norahueppi/Marvin_hw/Gehaeuse/BTN_V2.2.stl

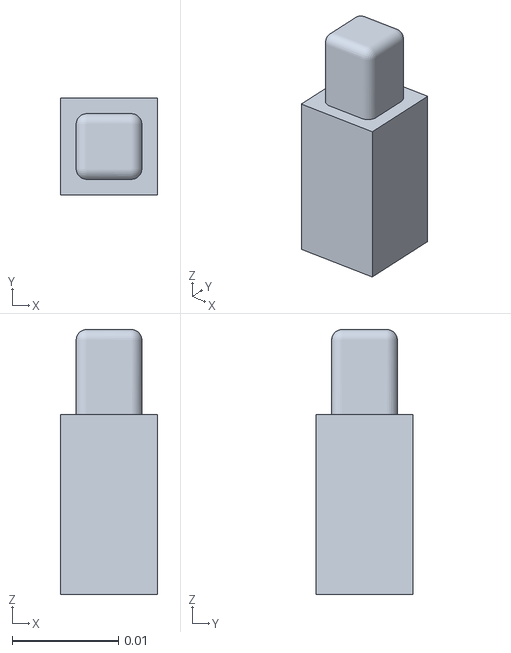
[picture p1: CAD file, 2025-06-20]
Gehaeuse/BTN_V2.2.stl
0.00913 x 0.00913 x 0.025
