norahueppi/Marvin_hw/Gehaeuse/Front.stl

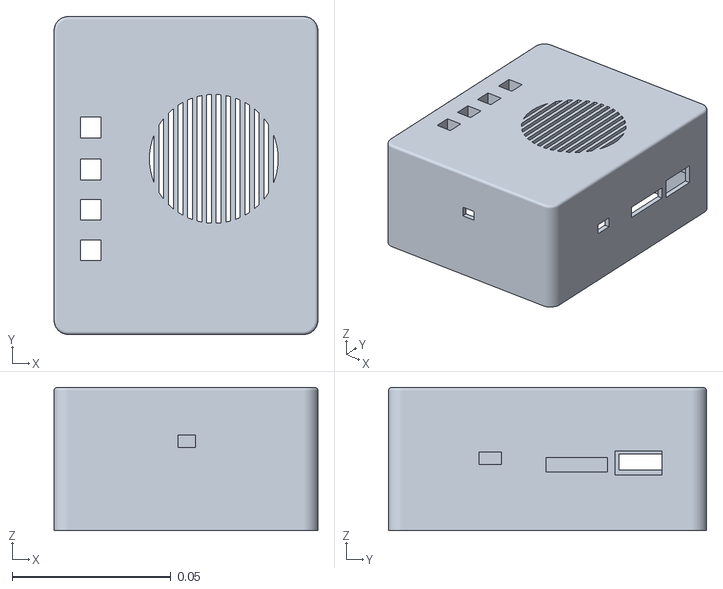
[picture p2: CAD file, 2025-06-13]
Gehaeuse/Front.stl
0.083 x 0.1 x 0.045
