norahueppi/Marvin_hw/Gehaeuse/Back.stl

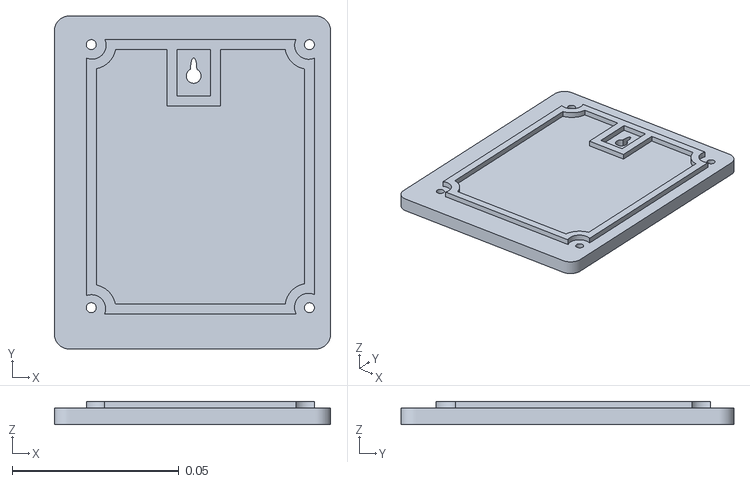
[picture p3: CAD file, 2025-06-13]
Gehaeuse/Back.stl
0.083 x 0.1 x 0.007
