norahueppi/Marvin_hw/Gehaeuse/BTN_V2.stl

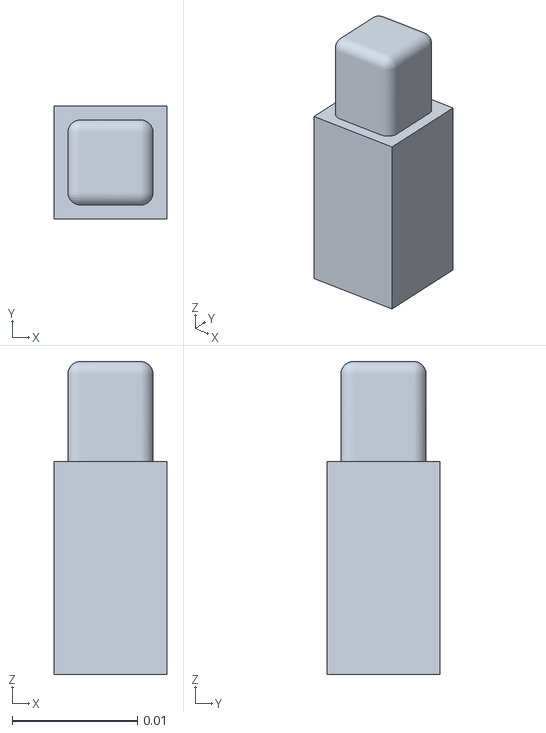
[picture p4: CAD file, 2025-06-20, an earlier design]
Gehaeuse/BTN_V2.stl
0.009 x 0.009 x 0.025
