norahueppi/Marvin_hw/MarvinProjekt.kicad_pcb

## KiCad design MarvinProjekt.kicad_pcb (2025-04-23)

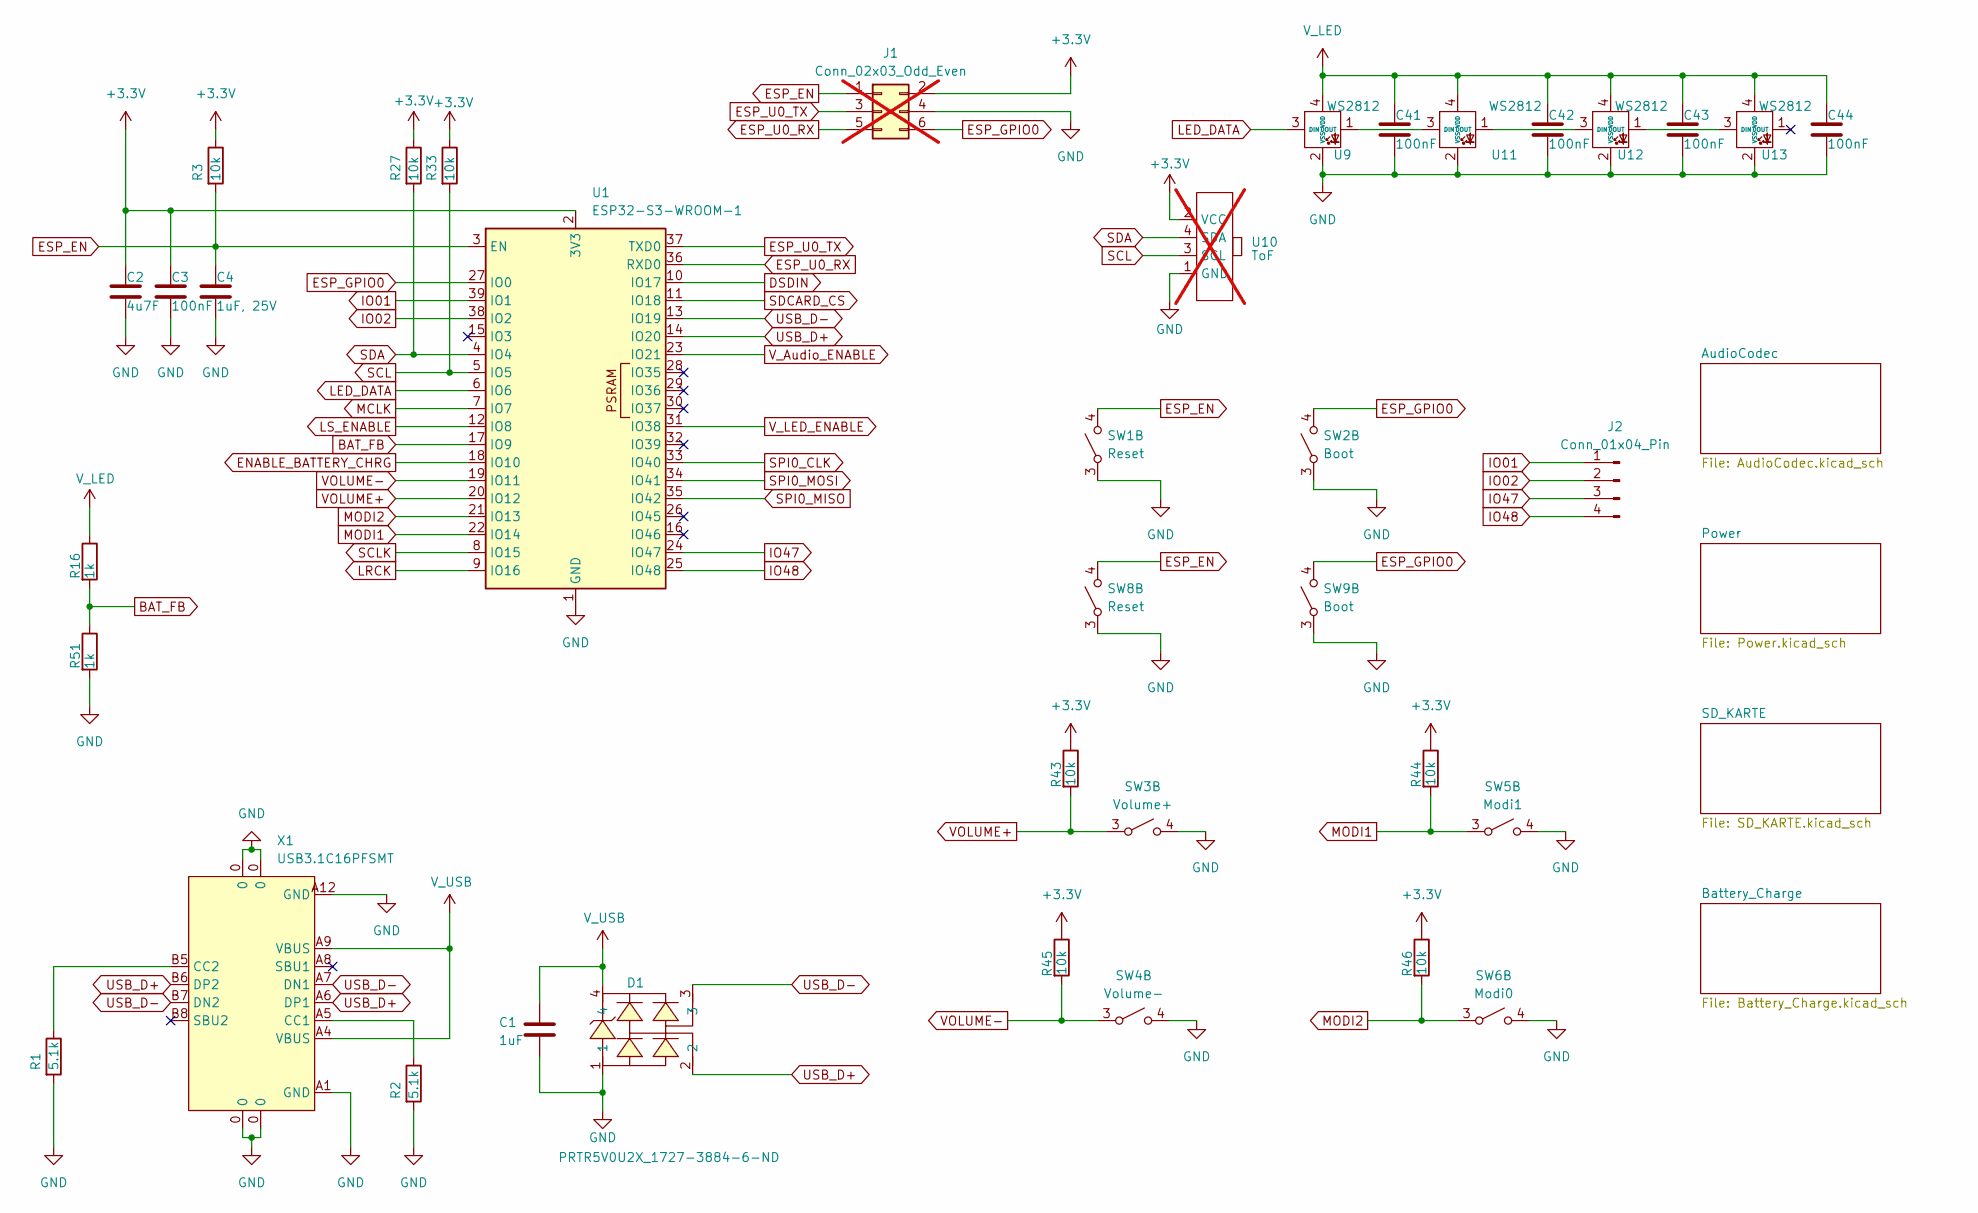
[picture p5: schematic MarvinProjekt.kicad_sch]

Parts:
C1: 1uF; C_0805_2012Metric_Pad1.18x1.45mm_HandSolder
C2: 4u7F; C_0805_2012Metric_Pad1.18x1.45mm_HandSolder; LCSC Part C1779
C3, C41, C42, C43, C44: 100nF; C_0805_2012Metric_Pad1.18x1.45mm_HandSolder
C4: 1uF, 25V; C_0805_2012Metric_Pad1.18x1.45mm_HandSolder
D1: PRTR5V0U2X_1727-3884-6-ND; SOT-143_Handsoldering; LCSC Part C2827688
J1: Conn_02x03_Odd_Even; PinHeader_2x03_P2.54mm_Vertical; not fitted
J2: Conn_01x04_Pin; PinHeader_1x04_P2.54mm_Vertical
R1, R2: 5.1k; R_0805_2012Metric_Pad1.20x1.40mm_HandSolder; LCSC Part C26023
R3, R27, R33, R43, R44, R45, R46: 10k; R_0805_2012Metric_Pad1.20x1.40mm_HandSolder
R16, R51: 1k; R_0805_2012Metric_Pad1.20x1.40mm_HandSolder
SW1, SW8: Reset; Taster; LCSC Part C127509
SW2, SW9: Boot; Taster; LCSC Part C127509
SW3: Volume+; Taster; LCSC Part C127509
SW4: Volume-; Taster; LCSC Part C127509
SW5: Modi1; Taster; LCSC Part C127509
SW6: Modi0; Taster; LCSC Part C127509
U1: ESP32-S3-WROOM-1; digikey ESP32-S3-WROOM-1-N4
U9, U11, U12, U13: WS2812; LED_WS2812B-2020_PLCC4_2.0x2.0mm
U10: ToF; not fitted
X1: USB3.1C16PFSMT; USB-C-SMD_TYPE-C-USB-17; LCSC Part C167321

Connections:
+3.3V: C2.1, C3.1, J1.2, R3.1, R27.1, R33.1, R43.1, R44.1, R45.1, R46.1, U1.2 (3V3), U10.2 (VCC); also elsewhere on the board
BAT_FB: R16.2, R51.1, U1.17 (IO9)
DSDIN: U1.10 (IO17); also elsewhere on the board
ENABLE_BATTERY_CHRG: U1.18 (IO10); also elsewhere on the board
ESP_EN: C4.1, J1.1, R3.2, SW1.4 (B), SW8.4 (B), U1.3 (EN)
ESP_GPIO0: J1.6, SW2.4 (B), SW9.4 (B), U1.27 (IO0)
ESP_U0_RX: J1.5, U1.36 (RXD0)
ESP_U0_TX: J1.3, U1.37 (TXD0)
GND: C1.2, C2.2, C3.2, C4.2, C41.2, C42.2, C43.2, C44.2, D1.1, J1.4, R1.2, R2.2, R51.2, SW1.3 (A), SW2.3 (A), SW3.4 (B), SW4.4 (B), SW5.4 (B), SW6.4 (B), SW8.3 (A), SW9.3 (A), U1.1 (GND), U1.40 (GND), U1.41 (GND), U9.2 (VSS), U10.1 (GND), U11.2 (VSS), U12.2 (VSS), U13.2 (VSS), X1.0, X1.A1 (GND), X1.A12 (GND); also elsewhere on the board
IO01: J2.1, U1.39 (IO1)
IO02: J2.2, U1.38 (IO2)
IO47: J2.3, U1.24 (IO47)
IO48: J2.4, U1.25 (IO48)
LED_DATA: U1.6 (IO6), U9.3 (DIN)
LRCK: U1.9 (IO16); also elsewhere on the board
LS_ENABLE: U1.12 (IO8); also elsewhere on the board
MCLK: U1.7 (IO7); also elsewhere on the board
MODI1: R44.2, SW5.3 (A), U1.22 (IO14)
MODI2: R46.2, SW6.3 (A), U1.21 (IO13)
unnamed: U9.1 (DOUT), U11.3 (DIN)
unnamed: U11.1 (DOUT), U12.3 (DIN)
unnamed: U12.1 (DOUT), U13.3 (DIN)
unnamed: R2.1, X1.A5 (CC1)
unnamed: R1.1, X1.B5 (CC2)
SCL: R33.2, U1.5 (IO5), U10.3 (SCL); also elsewhere on the board
SCLK: U1.8 (IO15); also elsewhere on the board
SDA: R27.2, U1.4 (IO4), U10.4 (SDA); also elsewhere on the board
SDCARD_CS: U1.11 (IO18); also elsewhere on the board
SPI0_CLK: U1.33 (IO40); also elsewhere on the board
SPI0_MISO: U1.35 (IO42); also elsewhere on the board
SPI0_MOSI: U1.34 (IO41); also elsewhere on the board
USB_D+: D1.2, U1.14 (IO20), X1.A6 (DP1), X1.B6 (DP2)
USB_D-: D1.3, U1.13 (IO19), X1.A7 (DN1), X1.B7 (DN2)
VOLUME+: R43.2, SW3.3 (A), U1.20 (IO12)
VOLUME-: R45.2, SW4.3 (A), U1.19 (IO11)
V_Audio_ENABLE: U1.23 (IO21); also elsewhere on the board
V_LED: C41.1, C42.1, C43.1, C44.1, R16.1, U9.4 (VDD), U11.4 (VDD), U12.4 (VDD), U13.4 (VDD); also elsewhere on the board
V_LED_ENABLE: U1.31 (IO38); also elsewhere on the board
V_USB: C1.1, D1.4, X1.A4 (VBUS), X1.A9 (VBUS); also elsewhere on the board

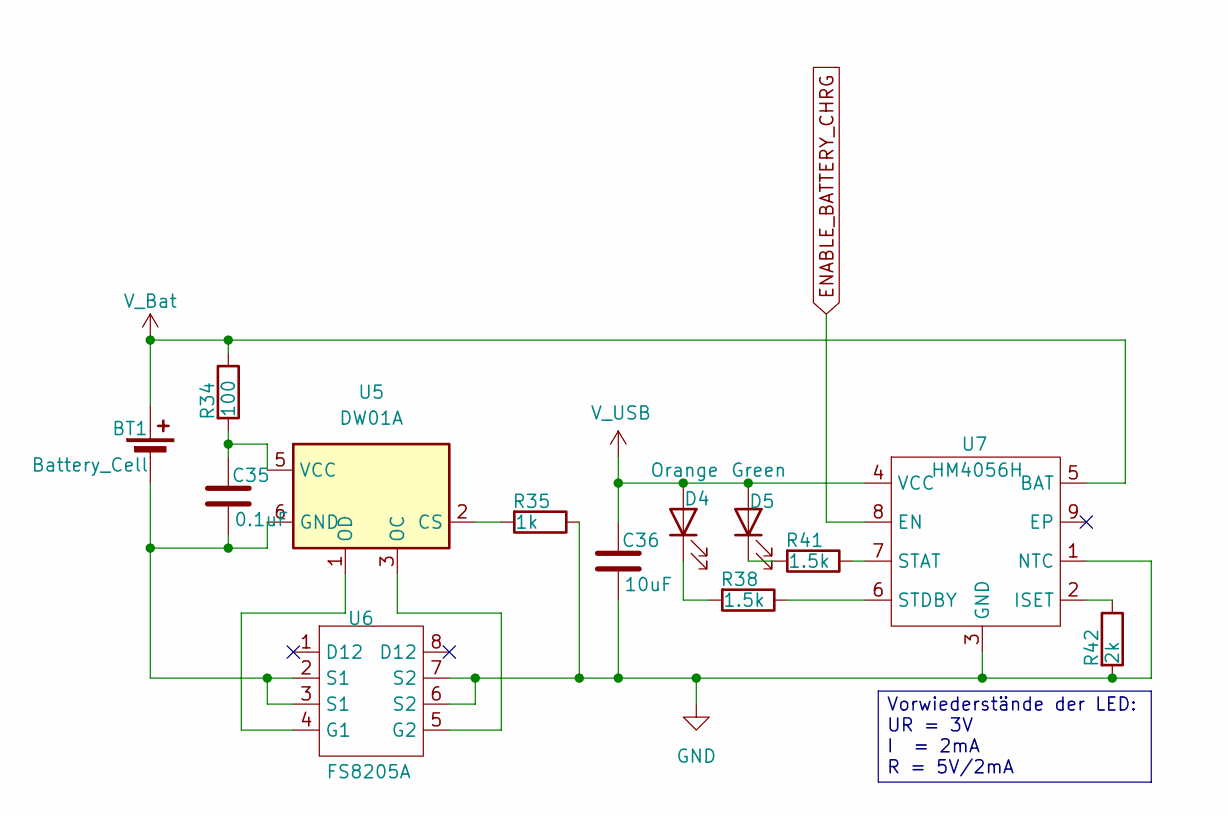
[picture p6: schematic Battery_Charge.kicad_sch]

Parts:
BT1: Battery_Cell; Batteriehalter; digikey 36-1043P-ND
C35: 0.1uF; C_0805_2012Metric_Pad1.18x1.45mm_HandSolder
C36: 10uF; C_1206_3216Metric_Pad1.33x1.80mm_HandSolder
D4: Orange; LED_0805_2012Metric
D5: Green; LED_0805_2012Metric
R34: 100; R_0805_2012Metric_Pad1.20x1.40mm_HandSolder
R35: 1k; R_0805_2012Metric_Pad1.20x1.40mm_HandSolder
R38, R41: 1.5k; R_0805_2012Metric_Pad1.20x1.40mm_HandSolder
R42: 2k; R_0805_2012Metric_Pad1.20x1.40mm_HandSolder
U5: DW01A; SOT-23-6; LCSC Part C351410
U6: FS8205A; TSSOP-8_4.4x3mm_P0.65mm; LCSC Part C7499846
U7: HM4056H; SOP-8-1EP_4.57x4.57mm_P1.27mm_EP4.57x4.45mm; LCSC Part C16581

Connections:
ENABLE_BATTERY_CHRG: U7.8 (EN); also elsewhere on the board
GND: C36.2, R35.1, R42.2, U6.6 (S2), U6.7 (S2), U7.1 (NTC), U7.3 (GND); also elsewhere on the board
unnamed: BT1.2 (-), C35.2, U5.6 (GND), U6.2 (S1), U6.3 (S1)
unnamed: D4.1 (K), R38.2
unnamed: D5.1 (K), R41.2
unnamed: R35.2, U5.2 (CS)
unnamed: U5.3 (OC), U6.5 (G2)
unnamed: U5.1 (OD), U6.4 (G1)
unnamed: C35.1, R34.2, U5.5 (VCC)
unnamed: R42.1, U7.2 (ISET)
unnamed: R41.1, U7.7 (STAT)
unnamed: R38.1, U7.6 (STDBY)
V_Bat: BT1.1 (+), R34.1, U7.5 (BAT); also elsewhere on the board
V_USB: C36.1, D4.2 (A), D5.2 (A), U7.4 (VCC); also elsewhere on the board

Notes on the sheet:
Vorwiederstände der LED: UR = 3V I = 2mA R = 5V/2mA

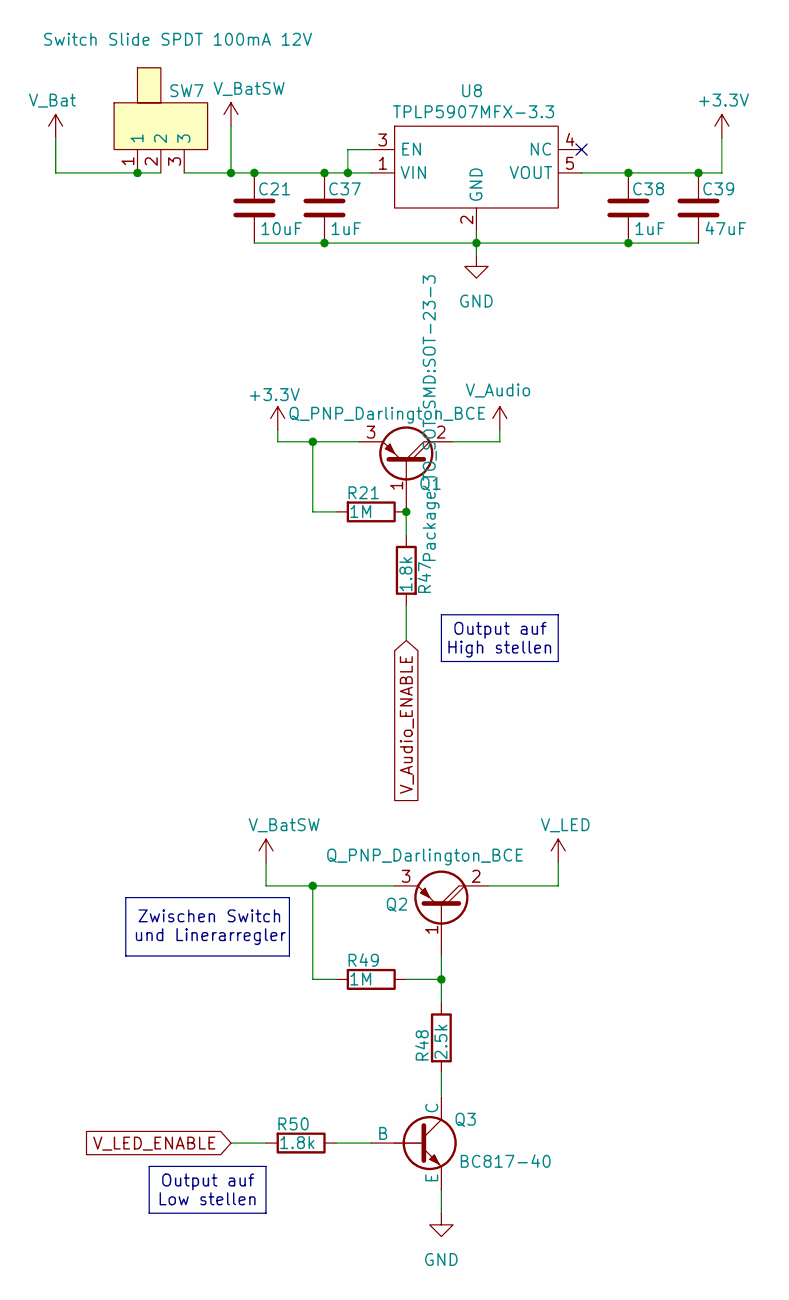
[picture p7: schematic Power.kicad_sch]

Parts:
C21: 10uF; C_1206_3216Metric_Pad1.33x1.80mm_HandSolder
C37, C38: 1uF; C_0805_2012Metric_Pad1.18x1.45mm_HandSolder
C39: 47uF; CP_Elec_6.3x5.9
Q1, Q2: Q_PNP_Darlington_BCE; SOT-23-3; LCSC Part C130420
Q3: BC817-40; SOT-23
R21, R49: 1M; R_0805_2012Metric_Pad1.20x1.40mm_HandSolder
R47, R50: 1.8k; R_0805_2012Metric_Pad1.20x1.40mm_HandSolder
R48: 2.5k; R_0805_2012Metric_Pad1.20x1.40mm_HandSolder
SW7: Switch Slide SPDT 100mA 12V; SW; LCSC Part OS102011MA1QN1
U8: TPLP5907MFX-3.3; SOT-23-5_HandSoldering; LCSC Part C460335

Connections:
+3.3V: C38.1, C39.1, Q1.3 (E), R21.2, U8.5 (VOUT); also elsewhere on the board
GND: C21.2, C37.2, C38.2, C39.2, Q3.3 (E), U8.2 (GND); also elsewhere on the board
unnamed: Q1.1 (B), R21.1, R47.1
unnamed: Q2.1 (B), R48.1, R49.1
unnamed: Q3.2 (B), R50.1
unnamed: Q3.1 (C), R48.2
V_Audio: Q1.2 (C); also elsewhere on the board
V_Audio_ENABLE: R47.2; also elsewhere on the board
V_Bat: SW7.1, SW7.2; also elsewhere on the board
V_BatSW: C21.1, C37.1, Q2.3 (E), R49.2, SW7.3, U8.1 (VIN), U8.3 (EN)
V_LED: Q2.2 (C); also elsewhere on the board
V_LED_ENABLE: R50.2; also elsewhere on the board

Notes on the sheet:
Output auf Low stellen
Output auf High stellen
Zwischen Switch und Linerarregler

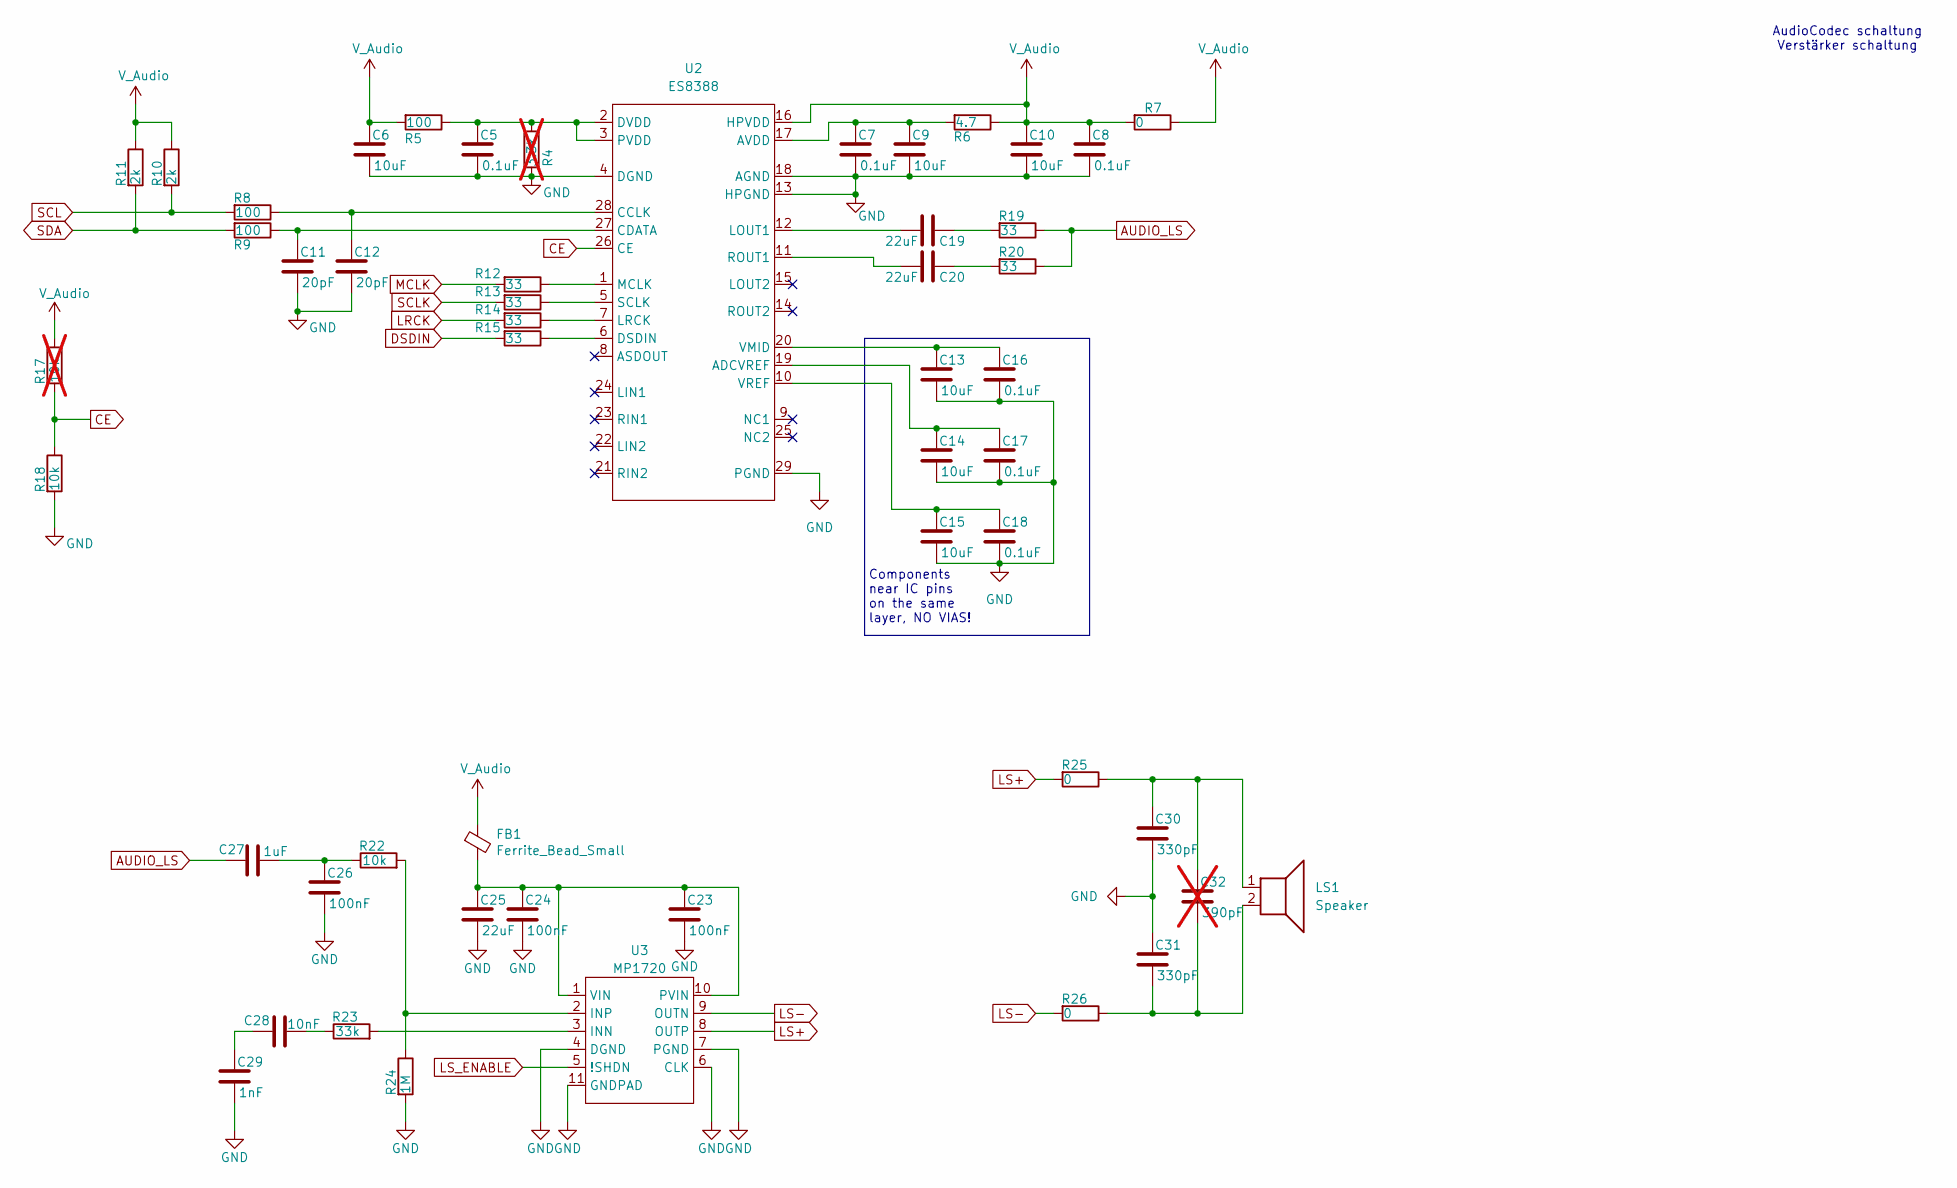
[picture p8: schematic AudioCodec.kicad_sch]

Parts:
C5, C7, C8, C16, C17, C18: 0.1uF; C_0805_2012Metric_Pad1.18x1.45mm_HandSolder
C6, C9, C10, C13, C14, C15: 10uF; C_1206_3216Metric_Pad1.33x1.80mm_HandSolder
C11, C12: 20pF; C_0805_2012Metric_Pad1.18x1.45mm_HandSolder
C19, C20, C25: 22uF; C_0805_2012Metric_Pad1.18x1.45mm_HandSolder
C23, C24, C26: 100nF; C_0805_2012Metric_Pad1.18x1.45mm_HandSolder
C27: 1uF; C_0805_2012Metric_Pad1.18x1.45mm_HandSolder
C28: 10nF; C_0805_2012Metric_Pad1.18x1.45mm_HandSolder
C29: 1nF; C_0805_2012Metric_Pad1.18x1.45mm_HandSolder
C30, C31: 330pF; C_0805_2012Metric_Pad1.18x1.45mm_HandSolder
C32: 390pF; C_0805_2012Metric_Pad1.18x1.45mm_HandSolder; not fitted
FB1: Ferrite_Bead_Small; L_0805_2012Metric; digikey 732-1613-1-ND
LS1: Speaker; LS
R4: 3.3k; R_0805_2012Metric_Pad1.20x1.40mm_HandSolder; not fitted
R5, R8, R9: 100; R_0805_2012Metric_Pad1.20x1.40mm_HandSolder
R6: 4.7; R_0805_2012Metric_Pad1.20x1.40mm_HandSolder
R7, R25, R26: 0; R_0805_2012Metric_Pad1.20x1.40mm_HandSolder
R10, R11: 2k; R_0805_2012Metric_Pad1.20x1.40mm_HandSolder
R12, R13, R14, R15, R19, R20: 33; R_0805_2012Metric_Pad1.20x1.40mm_HandSolder
R17: 10k; R_0805_2012Metric_Pad1.20x1.40mm_HandSolder; not fitted
R18, R22: 10k; R_0805_2012Metric_Pad1.20x1.40mm_HandSolder
R23: 33k; R_0805_2012Metric_Pad1.20x1.40mm_HandSolder
R24: 1M; R_0805_2012Metric_Pad1.20x1.40mm_HandSolder
U2: ES8388; QFN-28-1EP_4x4mm_P0.4mm_EP2.3x2.3mm; LCSC Part C365736
U3: MP1720

Connections:
AUDIO_LS: C27.1, R19.1, R20.1
CE: R17.2, R18.1, U2.26 (CE)
DSDIN: R15.2; also elsewhere on the board
GND: C5.2, C6.2, C7.2, C8.2, C9.2, C10.2, C11.2, C12.2, C13.2, C14.2, C15.2, C16.2, C17.2, C18.2, C23.2, C24.2, C25.2, C26.2, C29.2, C30.2, C31.1, R4.2, R18.2, R24.2, U2.4 (DGND), U2.13 (HPGND), U2.18 (AGND), U2.29 (PGND), U3.4 (DGND), U3.6 (CLK), U3.7 (PGND), U3.11 (GNDPAD); also elsewhere on the board
LRCK: R14.2; also elsewhere on the board
LS+: R25.2, U3.8 (OUTP)
LS-: R26.2, U3.9 (OUTN)
LS_ENABLE: U3.5 (!SHDN); also elsewhere on the board
MCLK: R12.2; also elsewhere on the board
unnamed: C19.1, R19.2
unnamed: C20.1, R20.2
unnamed: C26.1, C27.2, R22.1
unnamed: C28.1, C29.1
unnamed: C28.2, R23.1
unnamed: C30.1, C32.1, LS1.1, R25.1
unnamed: C31.2, C32.2, LS1.2, R26.1
unnamed: C14.1, C17.1, U2.19 (ADCVREF)
unnamed: C7.1, C9.1, R6.2, U2.17 (AVDD)
unnamed: C12.1, R8.1, U2.28 (CCLK)
unnamed: C11.1, R9.1, U2.27 (CDATA)
unnamed: R15.1, U2.6 (DSDIN)
unnamed: C5.1, R4.1, R5.1, U2.2 (DVDD), U2.3 (PVDD)
unnamed: C19.2, U2.12 (LOUT1)
unnamed: R14.1, U2.7 (LRCK)
unnamed: R12.1, U2.1 (MCLK)
unnamed: C20.2, U2.11 (ROUT1)
unnamed: R13.1, U2.5 (SCLK)
unnamed: C13.1, C16.1, U2.20 (VMID)
unnamed: C15.1, C18.1, U2.10 (VREF)
unnamed: R23.2, U3.3 (INN)
unnamed: R22.2, R24.1, U3.2 (INP)
unnamed: C23.1, C24.1, C25.1, FB1.2, U3.1 (VIN), U3.10 (PVIN)
SCL: R8.2, R10.2; also elsewhere on the board
SCLK: R13.2; also elsewhere on the board
SDA: R9.2, R11.2; also elsewhere on the board
V_Audio: C6.1, C8.1, C10.1, FB1.1, R5.2, R6.1, R7.1, R7.2, R10.1, R11.1, R17.1, U2.16 (HPVDD); also elsewhere on the board

Notes on the sheet:
AudioCodec schaltung Verstärker schaltung
Components near IC pins on the same layer, NO VIAS!

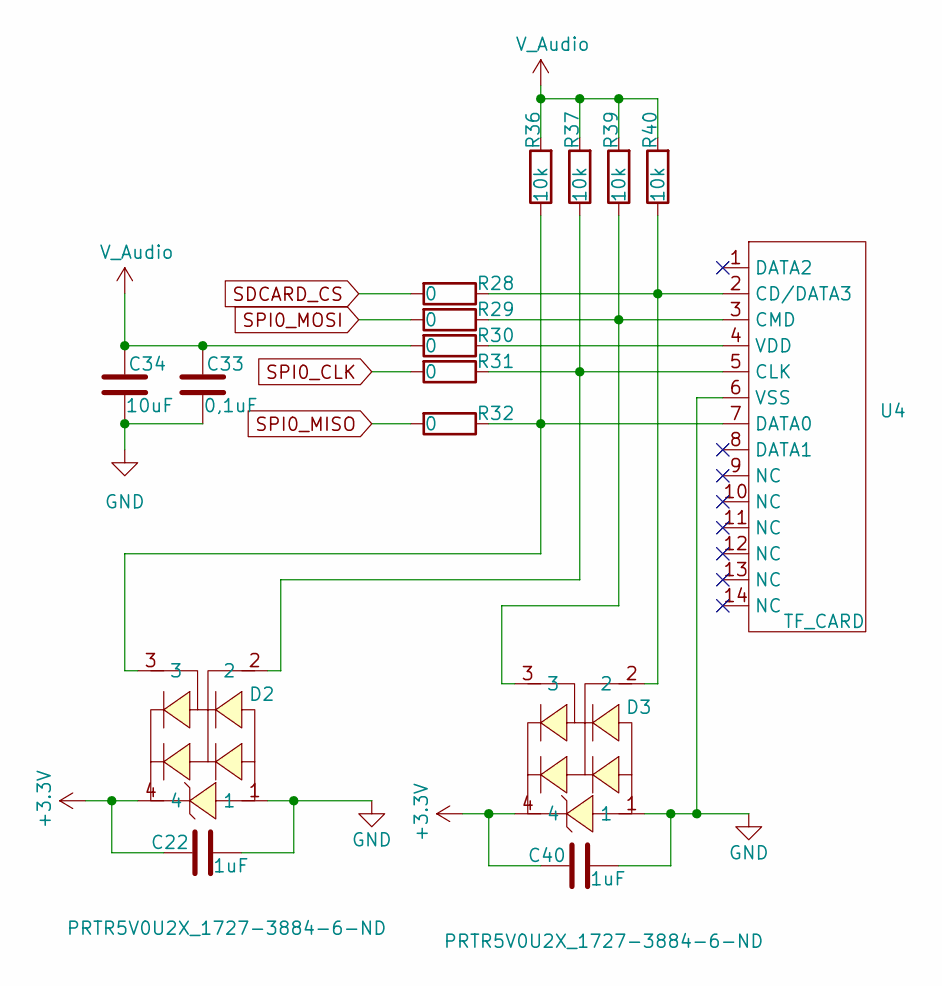
[picture p9: schematic SD_KARTE.kicad_sch]

Parts:
C22, C40: 1uF; C_0805_2012Metric_Pad1.18x1.45mm_HandSolder
C33: 0,1uF; C_0805_2012Metric_Pad1.18x1.45mm_HandSolder
C34: 10uF; C_1206_3216Metric_Pad1.33x1.80mm_HandSolder
D2, D3: PRTR5V0U2X_1727-3884-6-ND; SOT-143_Handsoldering; LCSC Part C2827688
R28, R29, R30, R31, R32: 0; R_0805_2012Metric_Pad1.20x1.40mm_HandSolder
R36, R37, R39, R40: 10k; R_0805_2012Metric_Pad1.20x1.40mm_HandSolder
U4: TF_CARD; 2096568

Connections:
+3.3V: C22.1, C40.1, D2.4, D3.4; also elsewhere on the board
GND: C22.2, C33.2, C34.2, C40.2, D2.1, D3.1, U4.6 (VSS); also elsewhere on the board
unnamed: D3.2, R28.1, R40.1, U4.2 (CD/DATA3)
unnamed: D2.2, R31.1, R37.1, U4.5 (CLK)
unnamed: D3.3, R29.1, R39.1, U4.3 (CMD)
unnamed: D2.3, R32.1, R36.1, U4.7 (DATA0)
unnamed: R30.1, U4.4 (VDD)
SDCARD_CS: R28.2; also elsewhere on the board
SPI0_CLK: R31.2; also elsewhere on the board
SPI0_MISO: R32.2; also elsewhere on the board
SPI0_MOSI: R29.2; also elsewhere on the board
V_Audio: C33.1, C34.1, R30.2, R36.2, R37.2, R39.2, R40.2; also elsewhere on the board

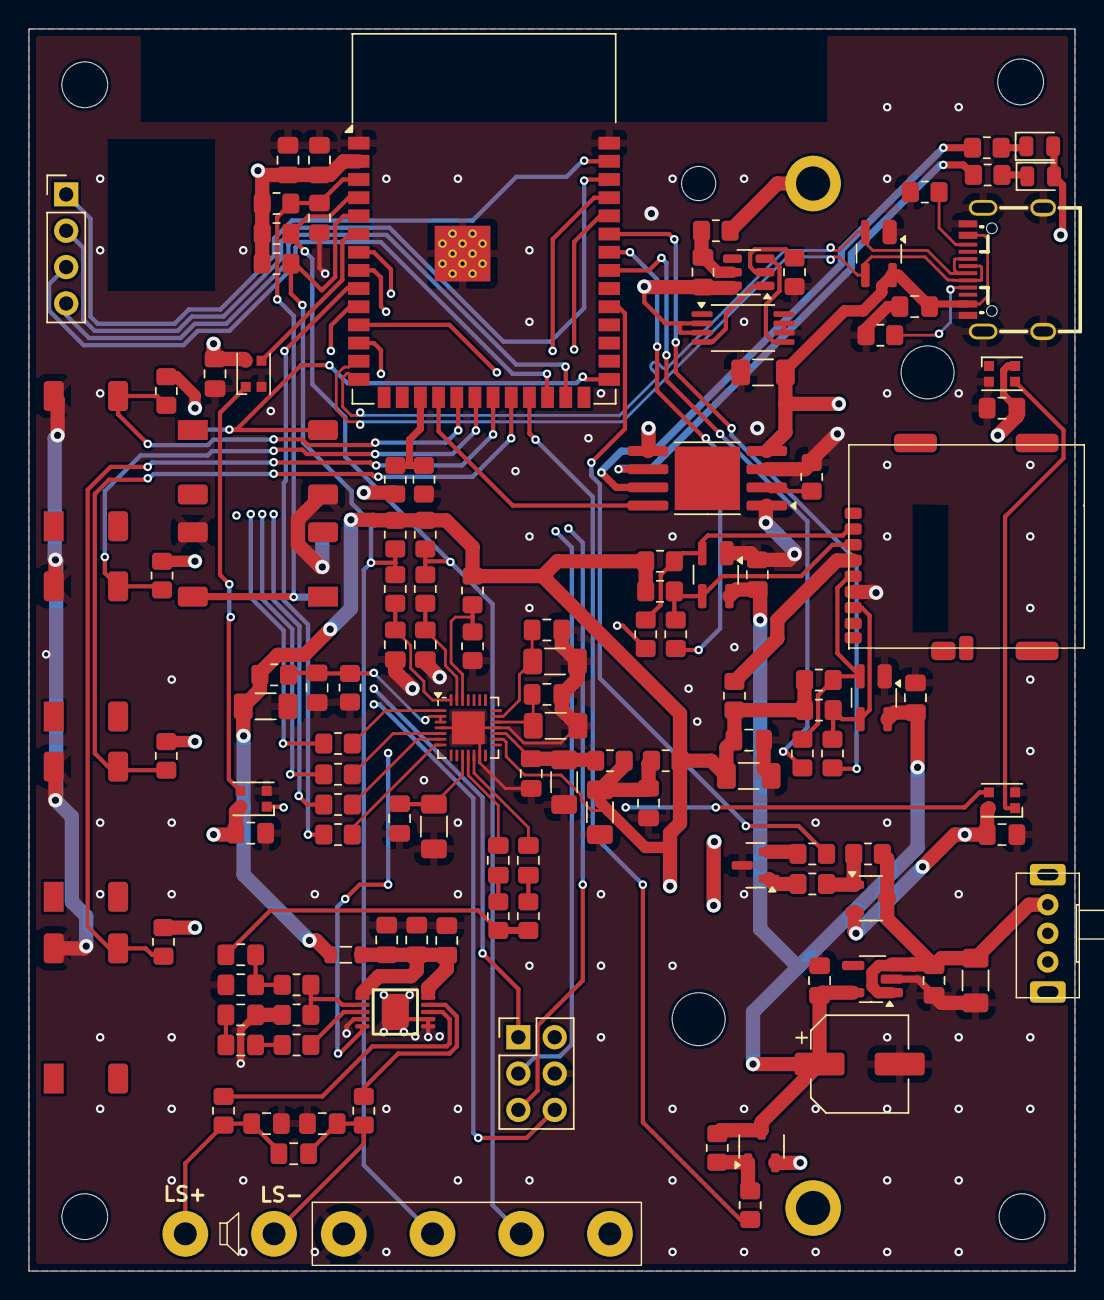
[picture p10: board MarvinProjekt.kicad_pcb from above]

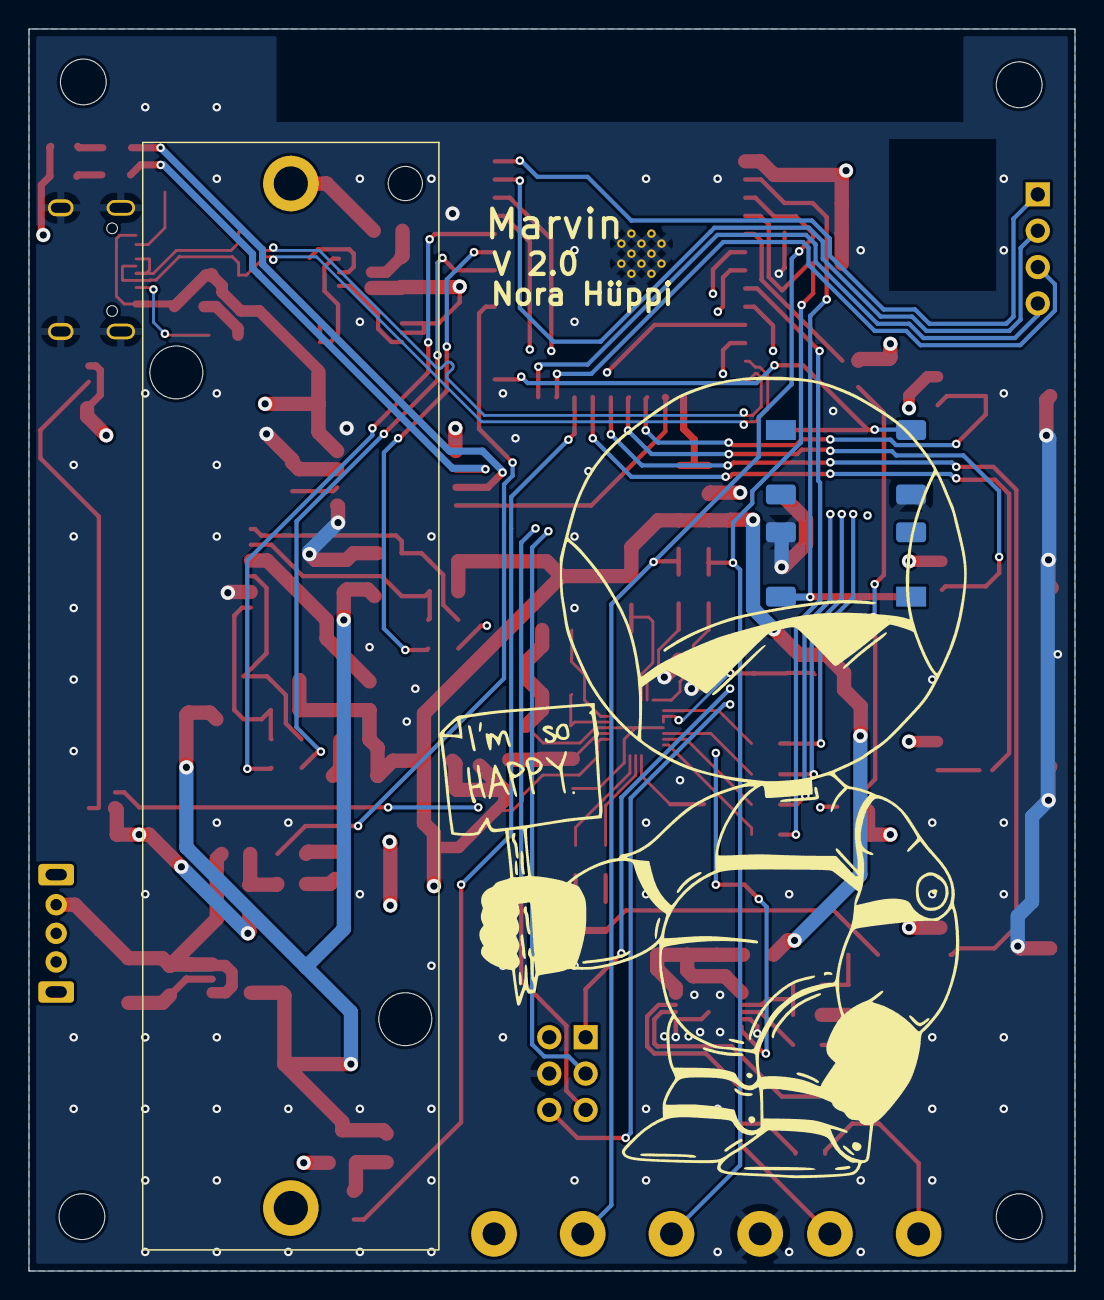
[picture p11: board MarvinProjekt.kicad_pcb from below]

Board: 4 copper layers, 73.1 x 86.8 mm, 131 parts (3 on the bottom side), 88 nets.
