norahueppi/Marvin_hw/(commit log)

2025-04-23 migrate kicad data from old repository in new repository
    This repository now contains the data from the KICAD files shortly after the order. These include:
    Production files for ordering the PCB.
    The BoM for ordering the components.
    The schematic.
    The layout.
    [AudioCodec.kicad_sch, Battery_Charge.kicad_sch, Control.kicad_sch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]
2025-06-12 add gehäuse
    [Front.step]
2025-06-13 add back and change front
    [Back.stl, Front.step, Front.stl]
2025-06-20 add dnp on pull up resistors
    [AudioCodec.kicad_sch, BTN_V2.2.stl, BTN_V2.stl]
